IAMREZAM/DC-motor-driver/report.pdf

| | نوع سند: گزارش فنی شماره سند: FP1403IE شماره گروه3:
طراحی و ساخت درایور موتور 24 ولت DC | نام اعضای گروه: 1( مصطفی خیابانی 2( رضا مومنی 3( آریستا منظم 4( سپهر عظیمی 5( عرفان رضایی

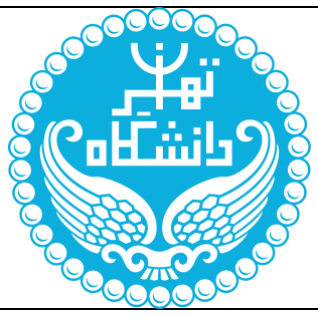
[picture p1: figure]

| | دانشکده فنی دانشگاه تهران مقطع: کارشناسی تاریخ تحویل سند: 1403/04/23
عنوان سند:
گزارش پایانی طراحی پروژه 3 نام درس:
الکترونیک صنعتی- بهار 1403 )استاد درس: کوروش خلج منفرد( کلمات کلیدی:

ی

فن
ده

شک

ن
د ران ا

گاهته

نش
د - ی | ا

یکصنعت
رون

لکت
یا
رپوژهپایا -بهار1403 | ن

سرفصل مطالب گزارش فنی

دادههای ورود ی مسئله 2 |
بخش -1 طراحی و انتخاب اجزا قدرت 2 |
طراحی و انتخاب خازن خروجی 3 |
طراحی و انتخاب سلف 3 |
طراحی و انتخاب کلی د ماسفت 3 |
طراحی و انتخاب دی ود 3 |
انتخاب گرماگی ر 3 |
بخش -2 طراحی گی ت درای و و مدار فی دبک 3 |
بخش -3 شب ی ه سازی 5 |
بخش -4 کدنوی سی کنترل کننده با می کروکنترلر 8ATMEGA 6 |
بخش -5 طراحی کنترل کننده با آی سی 494TL 9 |
بخش -6 طراحی بخش الکترون ی ک و برد مدار چاپ ی )PCB )9 |
بخش -7 ساخت و آزمون طرح 11 |

نوع سند: گزارش فنی شماره سند: FP1402IE شماره گروه3: تاریخ: 1403/04/23 دانشگاه تهران پروژه پایانی الکترونیک صنعتی

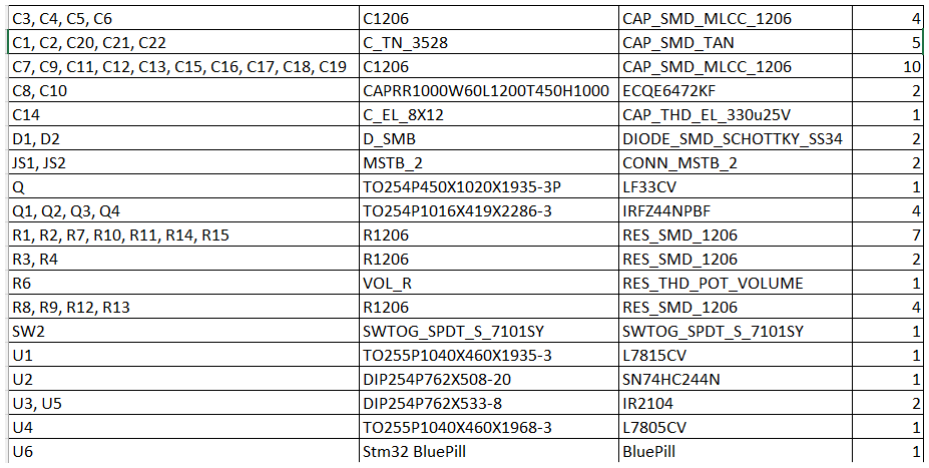
[picture p2: figure]

ران

گاهته

نش
یدا

فن
ده

شک

ن
د - ی | ا

یکصنعت
رون

لکت
یا
رپوژهپایا -بهار1403 | ن

دادههای ورودی مسئله
در این پروژه می خواهیم برای یک موتور dc درایور طراحی کنیم. این بر د یک ورودی به صورت و لووم و یک ورودی با کلید کلنگی در یافت میکند که اولی نشان د هند ه سرعت و دومی نشان د هند ه جهت چرخش موتور می باشد . پیاده سازی ا ین مد ار به کمک میکر وکنترلر و با استفاده از توپولوژی فو ل بریج می باشد . برای درایو کلیدهای و ایجاد Time Dead از آیسی 2104IR و مد ار بوت استرپ استفاده میکنیم. مشخصات فنی:
ورودی و لتاژ 24 DC و لت
خروجی موتور DC مغناطیس دائم نیازمندی های اصلی مدار:
STM32F103 Blupill یا ATmega8 | میکروکنترلر
گیت درایور 2104IR
کلید ماسفت )مثلا 740IRF )
پتانسیومتر برای دریافت مرجع سرعت کلید کلنگی برای تعیین جهت سرعت چرخش

بخش -1 طراحی و انتخاب اجزا قدرت

لیست کلی قطعات استفاده شده برای کنترل سرعت از یک پتانسیومتر و جهت چرخش از یک کلید کلنگی استفاده می کنیم،در ابتدا برای کلید کلنگی و پتانسیومتر یک مقاومت سری و یک خازن موازی تعبیه می کنیم چرا که قرار است تا کلید کلنگی به میکرو کنترلر متصل شود پس برای کنترل جریان عبوری و محدود کردن آن از مقاومت 10 کیلو

ران

گاهته

نش
یدا

فن
ده

شک

ن
د - ی | ا

یکصنعت
رون

لکت
یا
رپوژهپایا -بهار1403 | ن

اهمی استفاده می کنیم.خازن موازی شده نیز جهت گرفتن ریپل جریان به کار برده شده است و ظرفیت آن 100 نانو فاراد است که مقدار مناسبی برای این امر می باشد.شایان ذکر است که به همین خاطر برای پتانسیومتر متصل به میکرو نیز از یک خازن موازی استفاده می کنیم تا ریپل ولتاژ گرفته شده و نویز بی تاثیر شود.
بعد از صحبتی که با استاد انجام شد تصمیم بر آن شد که به جای 24 ولت از 15 ولت ورودی استفاده کنیم ،برای ورودی 15 ولتمان نیز از یک رگوالتور )که به دلیل ذکر شده با یک خازن موازی همراه است( استفاده کرده ایم. همچنین دلیل استفاده از LED نیز جهت اطمینان یافتن از اتصاالت درست مدار است به این صورت که با روشن بودن آن می توان متوجه صحت عملکرد شد. برای محدود کردن جریان عبوری از آن جهت جلوگیری از سوختنLED نیز مجددا از یک مقاومت سری 3.3 کیلو اهمی استفاده نموده ایم. در طرف دیگر نیز از دو خازن یکی سرامیکی و دیگری خازن پوالریزه تانتال می باشد که جهت دی کوپلینگ با میکرو و حذف نویز استفاده شده است. برای حذف نویز منبع در فول بریج از خازن دی کوپلینگ الکترولیتی استفاده کرده ایم. همچنین جهت جلوگیری از روشن شدن نا خواسته ماسفت بین پایه گیت و سورس آن مقاومت می گذاریم چرا که فرکانس کلید زنی ما زیاد است. طراحی و انتخاب خازن خروجی
کاربرد خازن هایی که در مدار قرار دادیم را در قسمت قبلی توضیح دادیم)خازن هایی برای فیلتر نویز و یا دیکوپلینگ(، برای انتخاب این خازن ها به ولتاژ و جریان قابل تحمل آنها برای قرارگیری در مدار توجه کردیم و با مشورت استاد آنها را در مدار قرار دادیم. طراحی و انتخاب سلف
در این مدار از سلف استفاده نشده است.

طراحی و انتخاب کلید ماسفت
سوییچ ها با توجه به ولتاژ و جریان عبوری انتخاب شده اند.

طراحی و انتخاب دیود
از دیود های شاتکی در مدار درایور استفاده شده است.)2104ir)

انتخاب گرماگیر
به دلیل کم بودن تلفات مدار نیازی به گرماگیر نبود.

بخش -2 طراحی گیت درایو و مدار فیدبک
در این مدار از درایور 2104IR استفاده شده است.

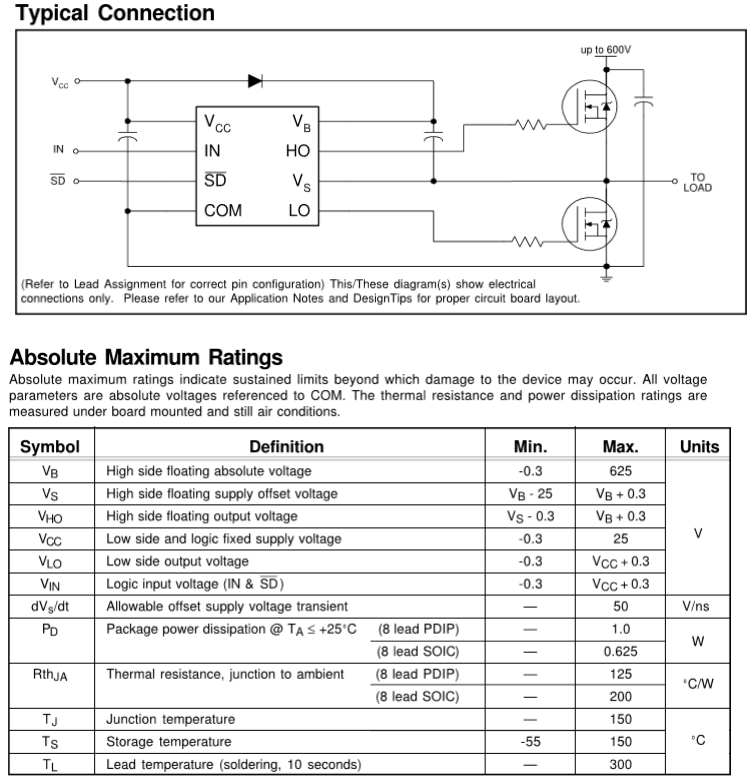
[picture p3: figure]

ران

گاهته

نش
یدا

فن
ده

شک

ن
د - ی | ا

یکصنعت
رون

لکت
یا
رپوژهپایا -بهار1403 | ن

2104IR ها درایور های ماسفت ها و IGBT های فشار قوی و پر سرعت با کانال های خروجی مرجع باال و پایین وابسته هستند. فناور ی های HVIC اختصاصی و CMOS ایمنی لچ، ساخت و ساز یکپارچه ناهموار را ممکن می سازد. ورودی منطق ی با خروج ی استاندارد CMOS یا LSTTL تا الجیک 3.3 ولت سازگار است. درایورهای خروجی دارای ی ک مرحله بافر جریان پالس باال هستند که برای حداقل رسانایی متقاطع درایور طراحی شده است. کانال شناور را می توان برای راه اندازی یک ماسفت برق کانال N ی ا IGBT در پیکربند ی سمت باال که از 10 تا 600 ولت کار می کند استفاده کرد. در واقع آیسی 2104IR، با توجه به مقدار منطقی پایه IN خود، پایه های HO و LO را برای ما مقداردهی میکند؛ پایه HO مقدار IN را میگیرد و پایه LO نیز NOT آن را بصورت خروجی میدهد.

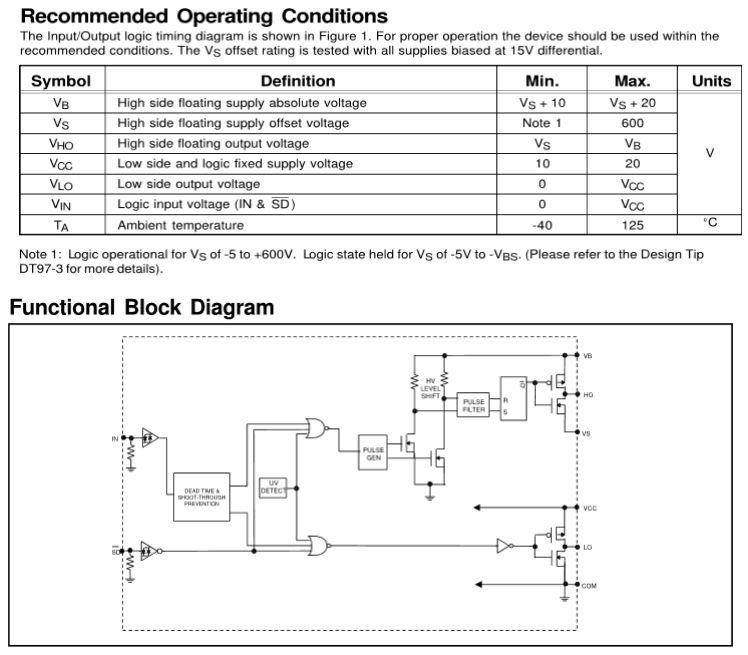
[picture p4: figure]

ران

گاهته

نش
یدا

فن
ده

شک

ن
د - ی | ا

یکصنعت
رون

لکت
یا
رپوژهپایا -بهار1403 | ن

بخش -3 شبیهسازی
شرایط مبدل خود را با ادوات انتخاب شده و با استفاده از یک کنترل کننده PI شبیه سازی کنید. خروجی های مبدل خود را گزارش کنید. آزمون دینامیکی در ازای تغییر %20 بار خروجی و %20 تغییرات در ولتاژ ورودی را نیز بررسی و گزارش کنید. برای شبیه سازی از نرم افزار متلب/سیمولینک یا PLECS می توانید استفاده کنید.

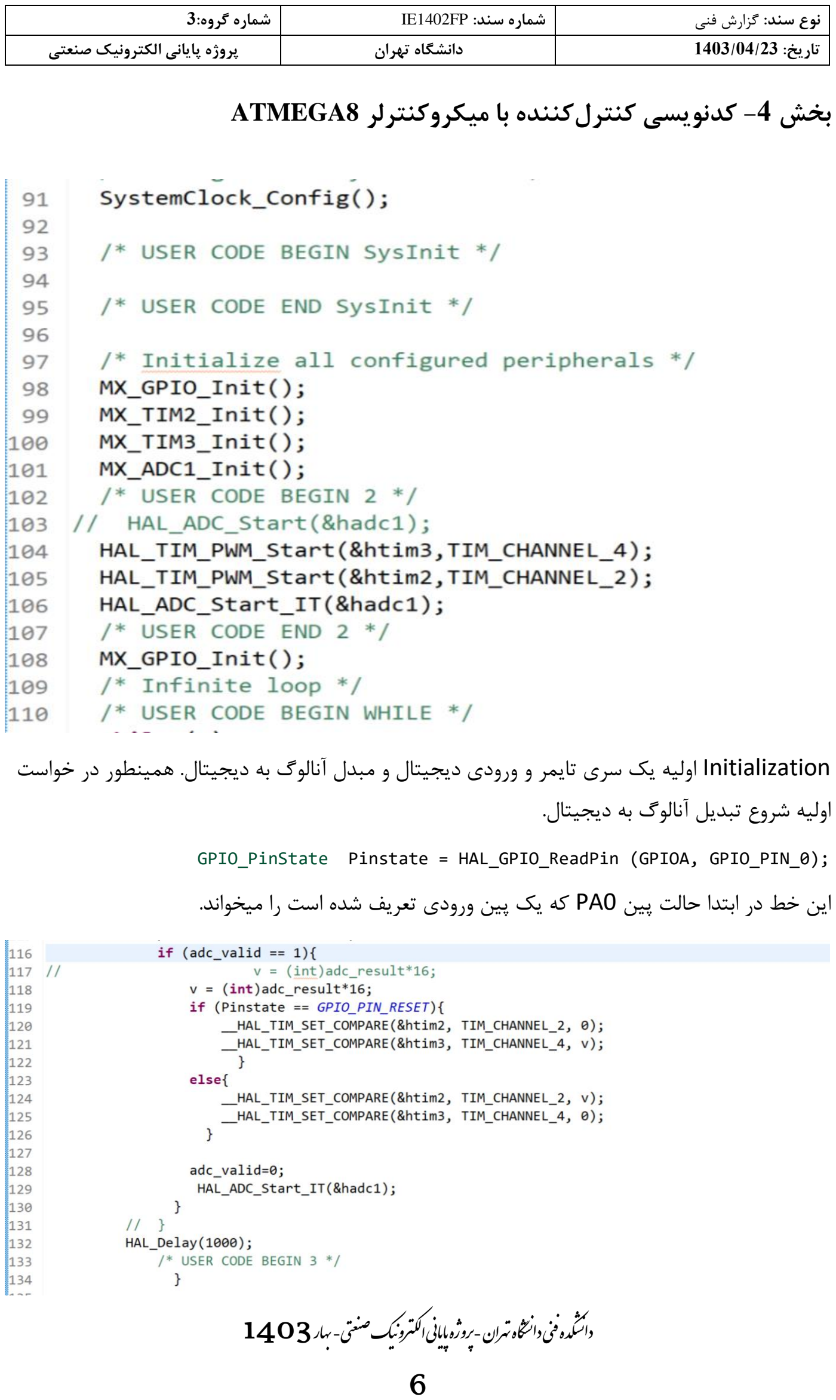
[picture p5: page 6]

ران

گاهته

نش
یدا

فن
ده

شک

ن
د - ی | ا

یکصنعت
رون

لکت
یا
رپوژهپایا -بهار1403 | ن

بخش -4 کدنویسی کنترلکننده با میکروکنترلر 8ATMEGA

Initialization اولیه یک سری تایمر و ورودی دیجیتال و مبدل آنالوگ به دیجیتال. همینطور در خواست اولیه شروع تبدیل آنالوگ به دیجیتال.

GPIO_PinState Pinstate = HAL_GPIO_ReadPin (GPIOA, GPIO_PIN_0);
این خط در ابتدا حالت پین 0PA که یک پین ورودی تعریف شده است را میخواند.

ران

گاهته

نش
یدا

فن
ده

شک

ن
د - ی | ا

یکصنعت
رون

لکت
یا
رپوژهپایا -بهار1403 | ن

سپس وقتی اینتراپت مربوط به ADC فعال شد و اعتبار خروجی مبدل آنالوگ به دیجیتال را تایید کرد میتوان خروجی را با توجه به رابطه بین ورودی 12 بیتی سرعت که به پتانسیومتر وصل است و تایمرهای تعریف شده برای PWM مقدار دیوت ی سایکل را برای اعمال به PWM ها محاسبه کرد.

= 4095 ¹² 2

65535/4095 = 16
65535 مقدار period Counter است. که حاصل دیوتی سایکل بصورت

100*period counter/CCR تعریف میشود و در تابع مربوط به آن مقدار آن در تایمر مورد نظر نوشته میشود.

جهت نیز با توجه به مقدار ورودی خوانده شده از 0PA تعیین میشود.

زمانی که مقدار این پین 0 باشد مقدار دیوتی سایکل PWM مربوط به تایمر 2 از کانال 2 و پین 1PA صفر میشود و مقدار دیوتی سایکل PWM مربوط به تایمر 3 از کانال 4 و پین 1PB با توجه به رابطه

. | میشود | محاسبه | v = (int)adc_result*16;

زمانی که مقدار این پین 1 باشد مقدار دیوتی سایکل PWM مربوط به تایمر 3 از کانال 4 و پین 1PB صفر میشود و مقدار دیوتی سایکل PWM مربوط به تایمر 2 از کانال 2 و پین 1PA با توجه به رابطه

. | میشود | محاسبه | v = (int)adc_result*16;

در نهایت متغیر مربوط به ولیدیتی adc را 0 کرده و دوباره برای شروع تبدیل آنالوگ به دیجیتال درخواست

HAL_ADC_Start_IT(&hadc1); کد | قطعه | با | میدهیم

قطعه کد زیر نیز مربوط به اینتراپت adc است که زمانی که تبدیل آنالوگ به دیجیتال تکمیل میشود فعال میشود:

در این تابع ولیدیتی مقدار adc 1 میشود و مقدار دیجیتال خوانده میشود.

void HAL_ADC_ConvCpltCallback(ADC_HandleTypeDef* hadc){ adc_valid = 1;
adc_result = HAL_ADC_GetValue(&hadc1); }

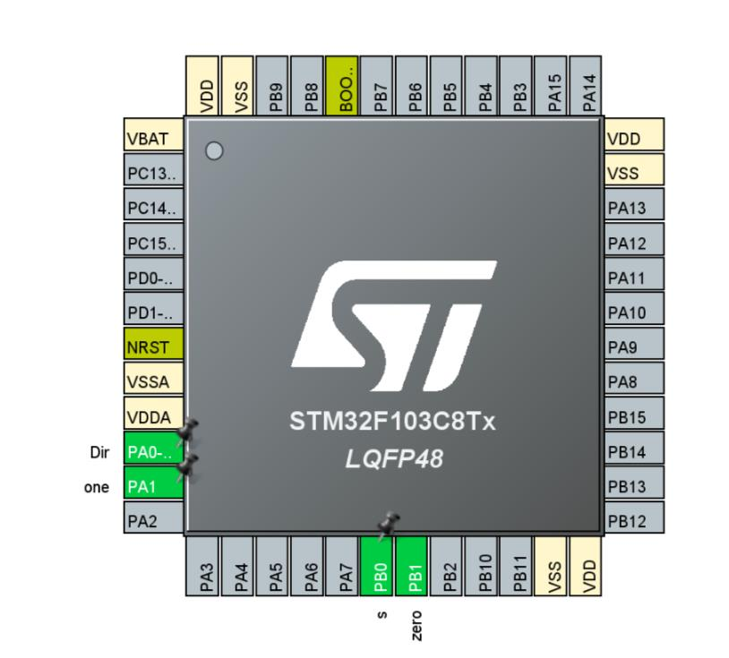
[picture p6: figure]

ران

گاهته

نش
یدا

فن
ده

شک

ن
د - ی | ا

یکصنعت
رون

لکت
یا
رپوژهپایا -بهار1403 | ن

همانطور که دیده میشود پایه 0PA برای تشخیص جهت به عنوان ورودی دیجیتال تعریف شده و مقدار 0 و 1 را برای ساعتگرد و پادساعتگرد بودن جهت چرخش میگیرد.

0PB نیز مقدار سرعت را میگیرد و به عنوان ADC تعریف شده.

پایه های 1PA , 1PB به عنوان تایمر با خروجی PWM تعریف شده اند.

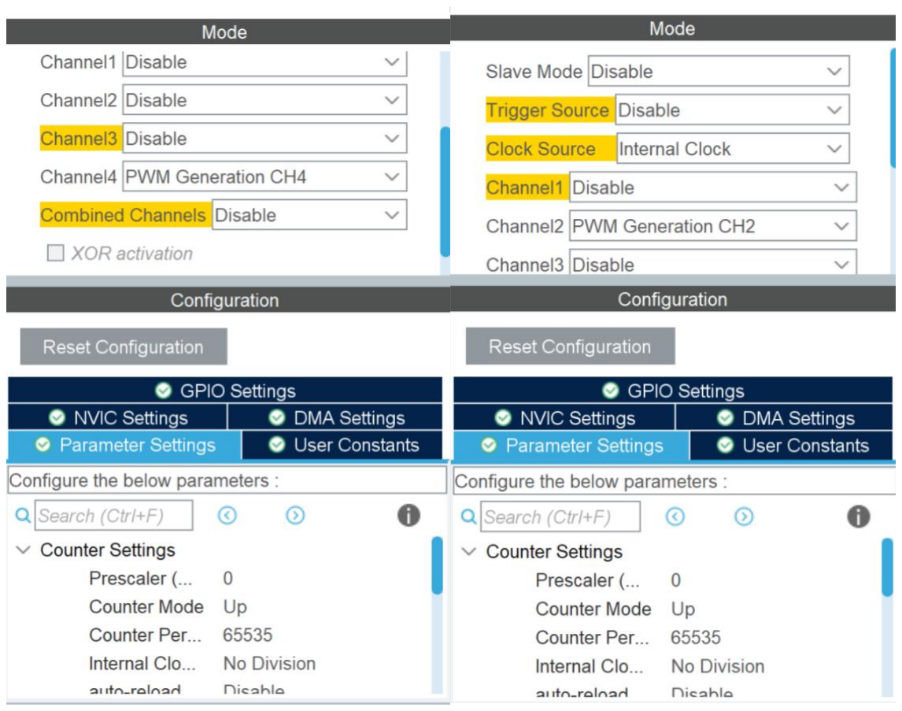
[picture p7: figure]

ران

گاهته

نش
یدا

فن
ده

شک

ن
د - ی | ا

یکصنعت
رون

لکت
یا
رپوژهپایا -بهار1403 | ن

بخش -5 طراحی کنترلکن نده با آیسی 494TL
در این پروژه از این آیسی استفاده نشده است.

بخش -6 طراحی بخش الکترونیک و برد مدار چاپی )PCB)
PCB طراحی شده دو الیه بوده و دارای ابعاد حدودی 8 در 9 سانتی متر می باشد.در این طراحی از پلی گان برای زمین استفاده شده است.شایان ذکر است که برای ورودی و خروجی مدار از فونیکس استفاده کرده ایم.برای تغذیه میکرو نیز از رگوالتور استفاده شده است.عرض ترک های بخش قدرت دو میلی متر و عرض ترک های متصل به پایه های ماسفت یک و نیم میلی متر می باشند.البته باید توجه داشت که عرض ترک های متصل به پایه آیسی 2104IR 0.5 میلی متر می باشد.در نهایت در چهار گوشه PCB جاهای پیچ به صورت ارت شده گذاشته شده است که به وسیله ترکی با عرض 0.3 میلی متر به یکدیگر متصل شده اند.

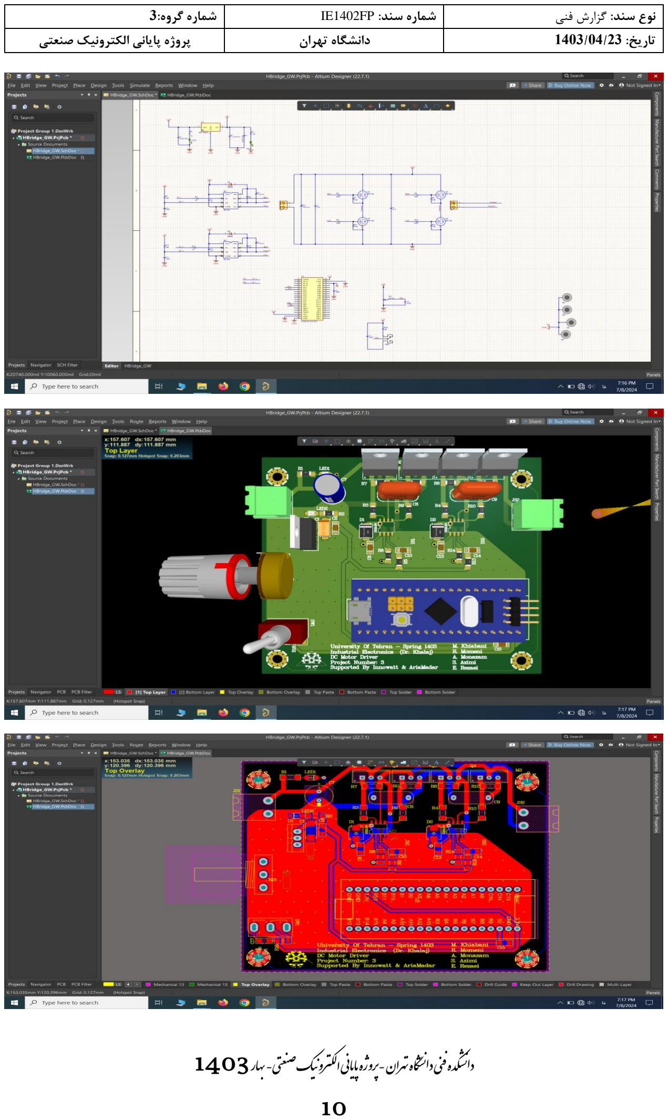
[picture p8: page 10]

ران

گاهته

نش
یدا

فن
ده

شک

ن
د - ی | ا

یکصنعت
رون

لکت
یا
رپوژهپایا -بهار1403 | ن

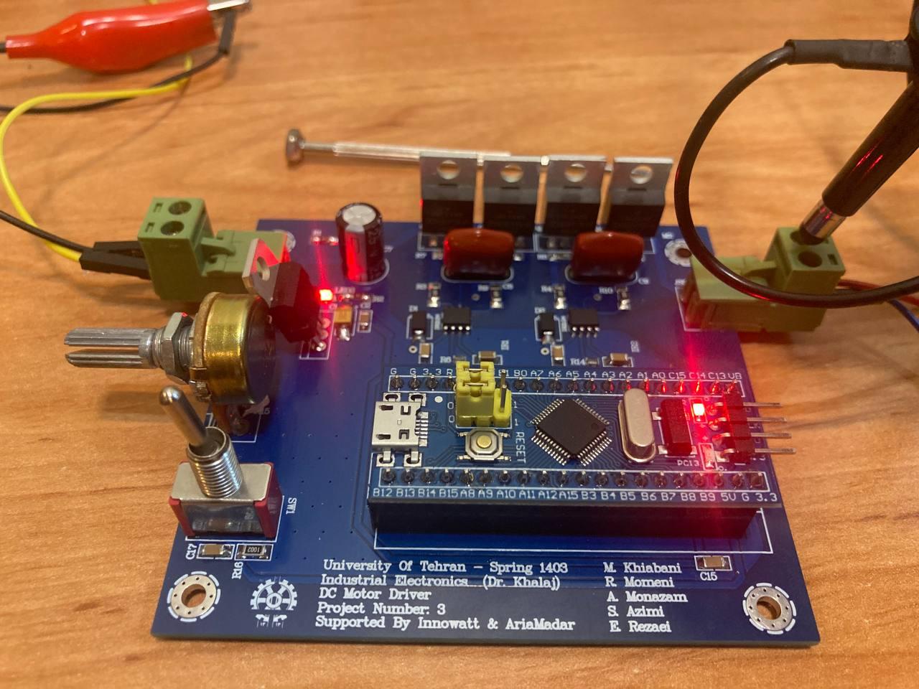
[picture p9: figure]

ران

گاهته

نش
یدا

فن
ده

شک

ن
د - ی | ا

یکصنعت
رون

لکت
یا
رپوژهپایا -بهار1403 | ن

PCBطراحی شده

بخش -7 ساخت و آزمون طرح

مدار مونتاژ شده

همانطور که مشاهده می شود قطعات مشخص شده بر روی PCB طراحی شده لحیم شده و بدین صورت بورد مونتاژ می شود.

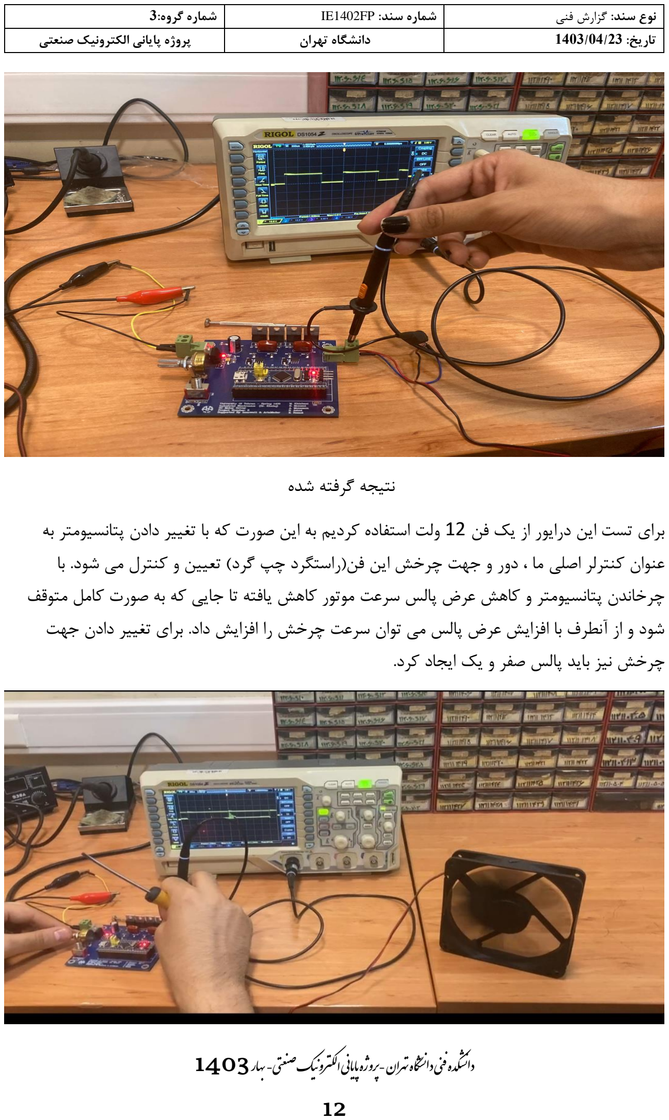
[picture p10: page 12]

ران

گاهته

نش
یدا

فن
ده

شک

ن
د - ی | ا

یکصنعت
رون

لکت
یا
رپوژهپایا -بهار1403 | ن

نتیجه گرفته شده

برای تست این درایور از یک فن 12 ولت استفاده کردیم به این صورت که با تغییر دادن پتانسیومتر به عنوان کنترلر اصلی ما ، دور و جهت چرخش این فن)راستگرد چپ گرد( تعیین و کنترل می شود. با چرخاندن پتانسیومتر و کاهش عرض پالس سرعت موتور کاهش یافته تا جایی که به صورت کامل متوقف شود و از آنطرف با افزایش عرض پالس می توان سرعت چرخش را افزایش داد. برای تغییر دادن جهت چرخش نیز باید پالس صفر و یک ایجاد کرد.

ران

گاهته

نش
یدا

فن
ده

شک

ن
د - ی | ا

یکصنعت
رون

لکت
یا
رپوژهپایا -بهار1403 | ن

چرخش فن در حداکثر سرعت
