IAMREZAM/DC-motor-driver/(list of files, drawings)

Other design files:
HBridge_GW.PcbDoc
HBridge_GW.PrjPcb
HBridge_GW.SchDoc
